jeremymatt/sugar_house_monitor/notes.txt

@reboot sleep 30 && DISPLAY=:0 /home/releaser/.venv/bin/python /home/releaser/sugar_house_monitor/ultrasonic_distance_test.py > /home/releaser/crontab.log 2>&1
https://sandboxelectronics.com/?product=sc16is750-i2cspi-to-uart-bridge-module
