jeremymatt/sugar_house_monitor/schematics/Figures.pptx

Flue O2
sensor

Holding tank
monitor

Transfer pump
controller

Flue temp
measurement

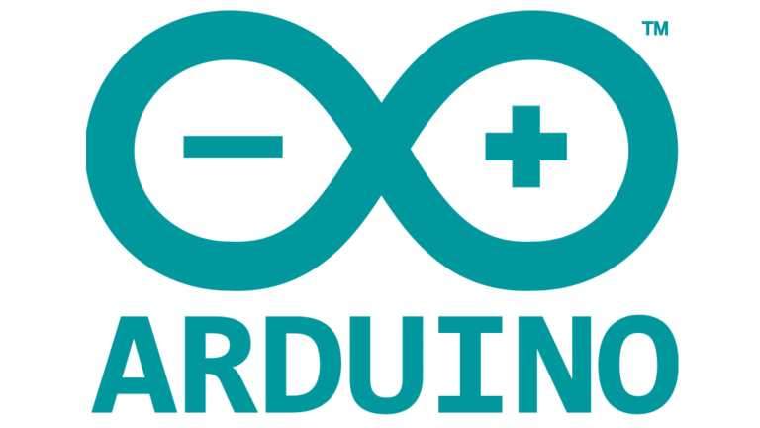
[picture p1: figure]
Arduino logo histoire et signification, evolution, symbole Arduino

Web browser
display

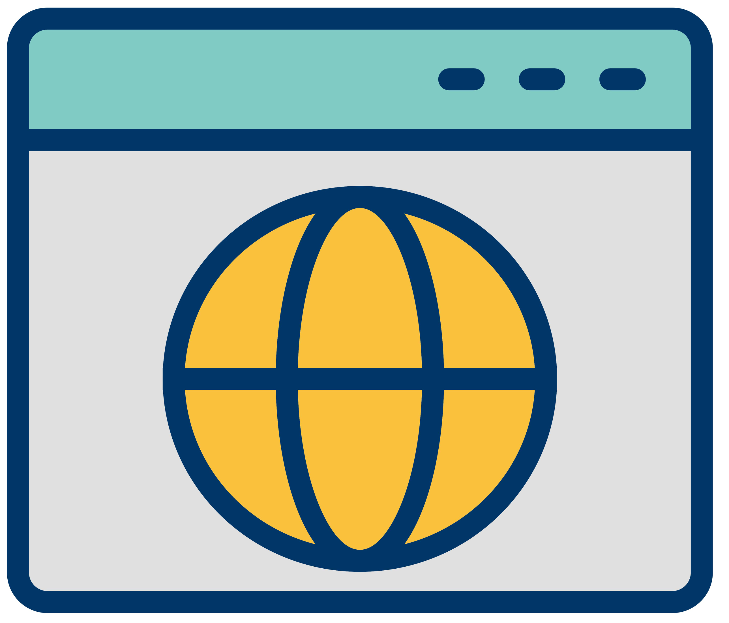
[picture p2: figure]
Vector Browser Icon 442546 Vector Art at Vecteezy

Webserver

Display
screen
