jeremymatt/sugar_house_monitor/schematics/pump_pi/screw_header_layout.pptx

Raspberry Pi header

GND

5V

GND

RED LED

GREEN LED

GND

5V

5V

Relay_in

unused

Relay_out

GND

GND

5V

GND

ADC ch0

ADC ch0

ADC ch1

(vacuum)

(tank full)

ADC ch2

ADC ch3

(manual pump)

(tank empty)

ADC ch4

ADC ch5

ADC ch6

(unused

(system on)

(system off)

ADC ch7

(reset errors
