jeremymatt/sugar_house_monitor/plot.png

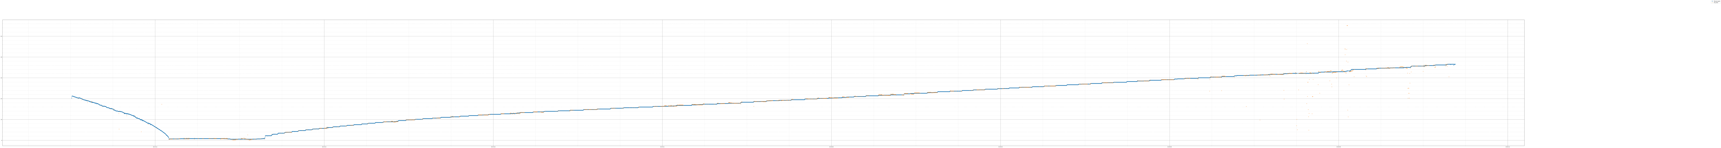
plot.png
