jeremymatt/sugar_house_monitor/schematics/Display case 3D files/complete_case.SLDASM

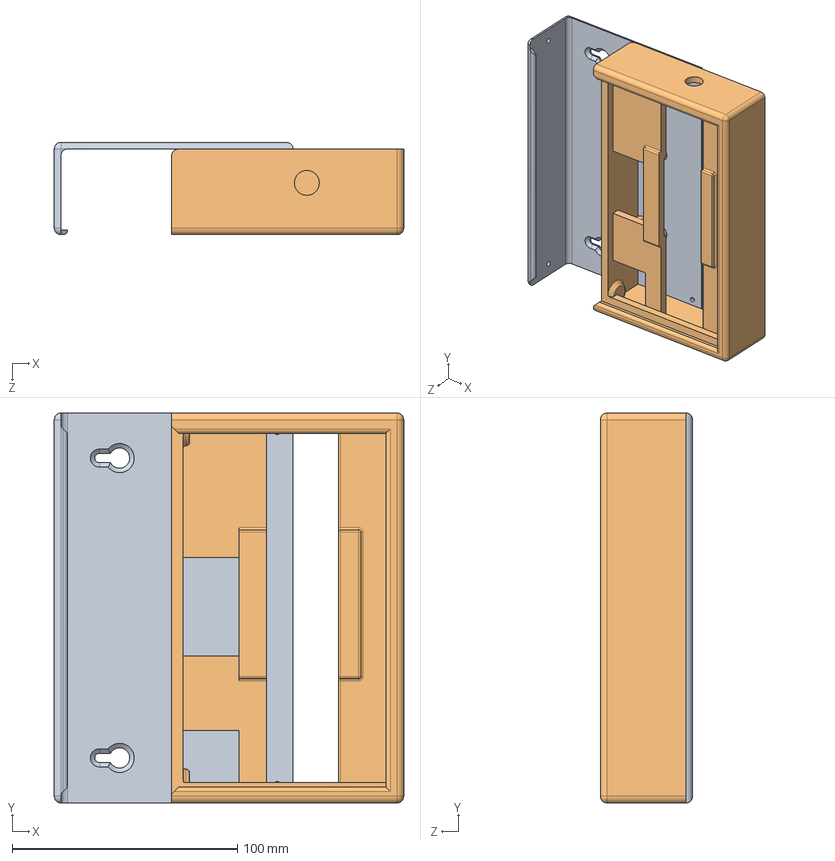
[picture p4: CAD file, 2026-06-21]
schematics/Display case 3D files/complete_case.SLDASM
155.1 x 173.0 x 41.0 mm
Main display case
Display case cover
