jeremymatt/sugar_house_monitor/schematics/Display case 3D files/Main display case.SLDPRT

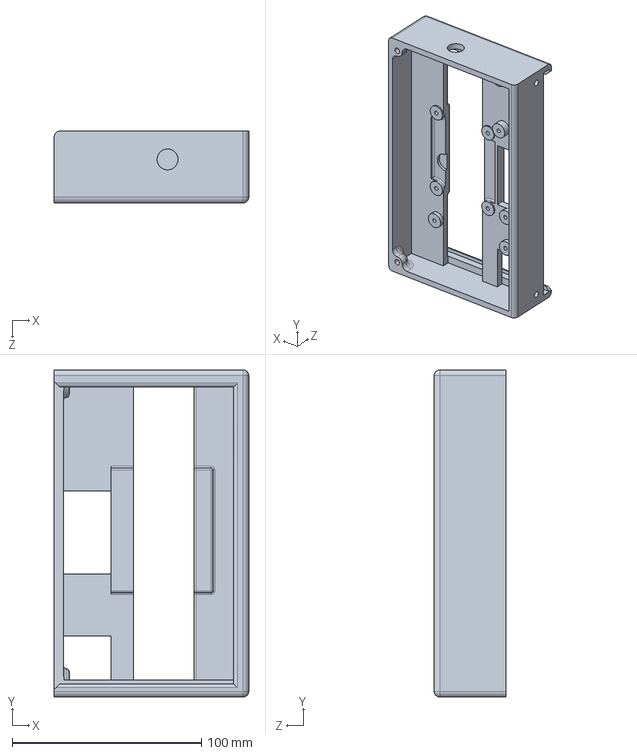
[picture p5: CAD file, 2026-06-21]
schematics/Display case 3D files/Main display case.SLDPRT
103.0 x 173.0 x 38.0 mm
