jeremymatt/sugar_house_monitor/schematics/Display case 3D files/Display case cover.SLDPRT

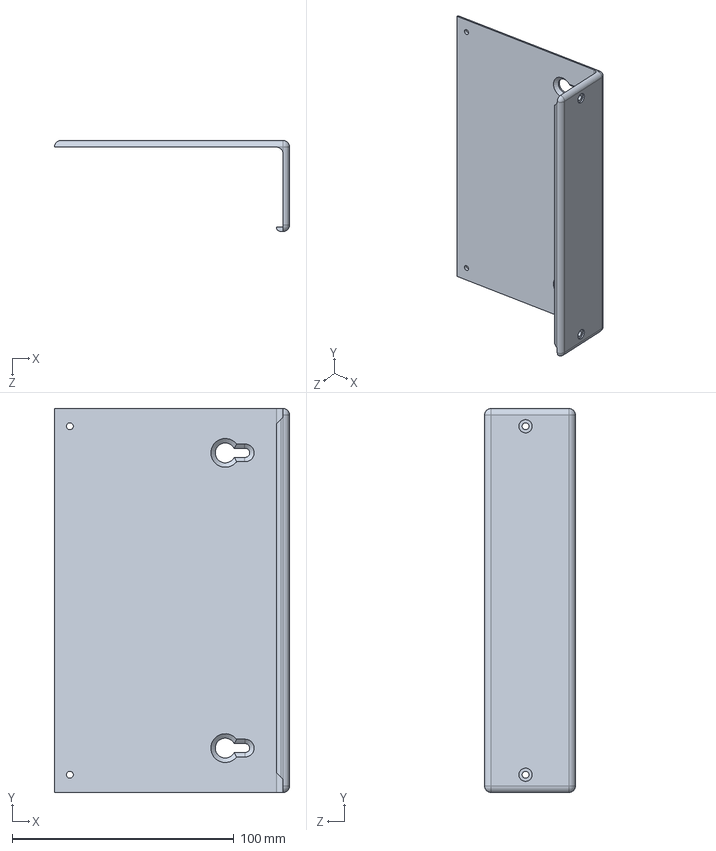
[picture p6: CAD file, 2026-06-21]
schematics/Display case 3D files/Display case cover.SLDPRT
106.0 x 173.0 x 41.0 mm
