jeremymatt/sugar_house_monitor/(list of files, cad)

Other CAD files:
schematics/Display case 3D files/Display case cover.STL
schematics/Display case 3D files/Main display case.3mf
schematics/Display case 3D files/Main display case.STL
