jeremymatt/sugar_house_monitor/bkup_2026-01-11/smoothing_testing/dataset/roadside_2025_04_04.csv

Unnamed: 0 | timestamp | yr | mo | day | hr | m | s | surf_dist | depth | gal
4708 | 2025-04-04 08:50:08.818582 | 2025.0 | 4.0 | 4.0 | 8.0 | 50.0 | 8.0 | 25.43 | 25.32 | 949.5
4709 | 2025-04-04 08:50:23.818658 | 2025.0 | 4.0 | 4.0 | 8.0 | 50.0 | 23.0 | 25.45 | 25.3 | 948.87
4710 | 2025-04-04 08:50:38.818622 | 2025.0 | 4.0 | 4.0 | 8.0 | 50.0 | 38.0 | 25.43 | 25.32 | 949.7
4711 | 2025-04-04 08:50:53.818643 | 2025.0 | 4.0 | 4.0 | 8.0 | 50.0 | 53.0 | 25.43 | 25.32 | 949.7
4712 | 2025-04-04 08:51:08.818652 | 2025.0 | 4.0 | 4.0 | 8.0 | 51.0 | 8.0 | 25.43 | 25.32 | 949.7
4713 | 2025-04-04 08:51:23.818701 | 2025.0 | 4.0 | 4.0 | 8.0 | 51.0 | 23.0 | 25.43 | 25.32 | 949.7
4714 | 2025-04-04 08:51:38.818661 | 2025.0 | 4.0 | 4.0 | 8.0 | 51.0 | 38.0 | 25.43 | 25.32 | 949.7
4715 | 2025-04-04 08:51:53.818726 | 2025.0 | 4.0 | 4.0 | 8.0 | 51.0 | 53.0 | 25.43 | 25.32 | 949.7
4716 | 2025-04-04 08:52:08.818703 | 2025.0 | 4.0 | 4.0 | 8.0 | 52.0 | 8.0 | 25.425 | 25.325000000000003 | 949.91
4717 | 2025-04-04 08:52:23.818760 | 2025.0 | 4.0 | 4.0 | 8.0 | 52.0 | 23.0 | 25.39 | 25.36 | 951.37
4718 | 2025-04-04 08:52:38.818719 | 2025.0 | 4.0 | 4.0 | 8.0 | 52.0 | 38.0 | 25.36 | 25.39 | 952.62
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
