jeremymatt/sugar_house_monitor/testdata/brookside.csv

Unnamed: 0 | timestamp | yr | mo | day | hr | m | s | surf_dist | depth | gal
318 | 2025-03-30 21:02:11.072244 | 2025.0 | 3.0 | 30.0 | 21.0 | 2.0 | 11.0 | 13.425 | 41.7 | 1350.32
319 | 2025-03-30 21:02:26.066835 | 2025.0 | 3.0 | 30.0 | 21.0 | 2.0 | 26.0 | 12.9475 | 42.18 | 1350.32
320 | 2025-03-30 21:02:41.066778 | 2025.0 | 3.0 | 30.0 | 21.0 | 2.0 | 41.0 | 13.53625 | 41.59 | 1350.32
321 | 2025-03-30 21:02:56.067176 | 2025.0 | 3.0 | 30.0 | 21.0 | 2.0 | 56.0 | 13.725 | 41.4 | 1350.32
322 | 2025-03-30 21:03:11.066261 | 2025.0 | 3.0 | 30.0 | 21.0 | 3.0 | 11.0 | 13.85 | 41.28 | 1350.32
323 | 2025-03-30 21:03:26.066451 | 2025.0 | 3.0 | 30.0 | 21.0 | 3.0 | 26.0 | 10.24625 | 44.88 | 1350.32
324 | 2025-03-30 21:03:41.066214 | 2025.0 | 3.0 | 30.0 | 21.0 | 3.0 | 41.0 | 98.06125 | -42.94 | 0.0
325 | 2025-03-30 21:03:56.066256 | 2025.0 | 3.0 | 30.0 | 21.0 | 3.0 | 56.0 | 120.1125 | -64.99 | 0.0
326 | 2025-03-30 21:04:11.066164 | 2025.0 | 3.0 | 30.0 | 21.0 | 4.0 | 11.0 | 98.2675 | -43.14 | 0.0
327 | 2025-03-30 21:04:26.067435 | 2025.0 | 3.0 | 30.0 | 21.0 | 4.0 | 26.0 | 70.33500000000001 | -15.21 | 0.0
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
