jeremymatt/sugar_house_monitor/testdata/roadside.csv

Unnamed: 0 | timestamp | yr | mo | day | hr | m | s | surf_dist | depth | gal
0 | 2025-03-30 21:02:10.366711 | 2025.0 | 3.0 | 30.0 | 21.0 | 2.0 | 10.0 | 18.17875 | 37.82 | 1471.35
1 | 2025-03-30 21:02:25.331935 | 2025.0 | 3.0 | 30.0 | 21.0 | 2.0 | 25.0 | 12.597499999999998 | 43.4 | 1520.53
2 | 2025-03-30 21:02:40.332445 | 2025.0 | 3.0 | 30.0 | 21.0 | 2.0 | 40.0 | 13.11625 | 42.88 | 1520.53
3 | 2025-03-30 21:02:55.331805 | 2025.0 | 3.0 | 30.0 | 21.0 | 2.0 | 55.0 | 13.31375 | 42.69 | 1520.53
4 | 2025-03-30 21:03:10.331566 | 2025.0 | 3.0 | 30.0 | 21.0 | 3.0 | 10.0 | 13.49125 | 42.51 | 1520.53
5 | 2025-03-30 21:03:25.331576 | 2025.0 | 3.0 | 30.0 | 21.0 | 3.0 | 25.0 | 11.4775 | 44.52 | 1520.53
6 | 2025-03-30 21:03:40.331475 | 2025.0 | 3.0 | 30.0 | 21.0 | 3.0 | 40.0 | 9.72125 | 46.28 | 1520.53
7 | 2025-03-30 21:03:55.331892 | 2025.0 | 3.0 | 30.0 | 21.0 | 3.0 | 55.0 | 9.77375 | 46.23 | 1520.53
8 | 2025-03-30 21:04:10.331520 | 2025.0 | 3.0 | 30.0 | 21.0 | 4.0 | 10.0 | 9.7925 | 46.21 | 1520.53
9 | 2025-03-30 21:04:25.331615 | 2025.0 | 3.0 | 30.0 | 21.0 | 4.0 | 25.0 | 9.81625 | 46.18 | 1520.53
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
