jeremymatt/sugar_house_monitor/bkup_2026-01-11/smoothing_testing/plots/brookside_hampel_flow_020.png

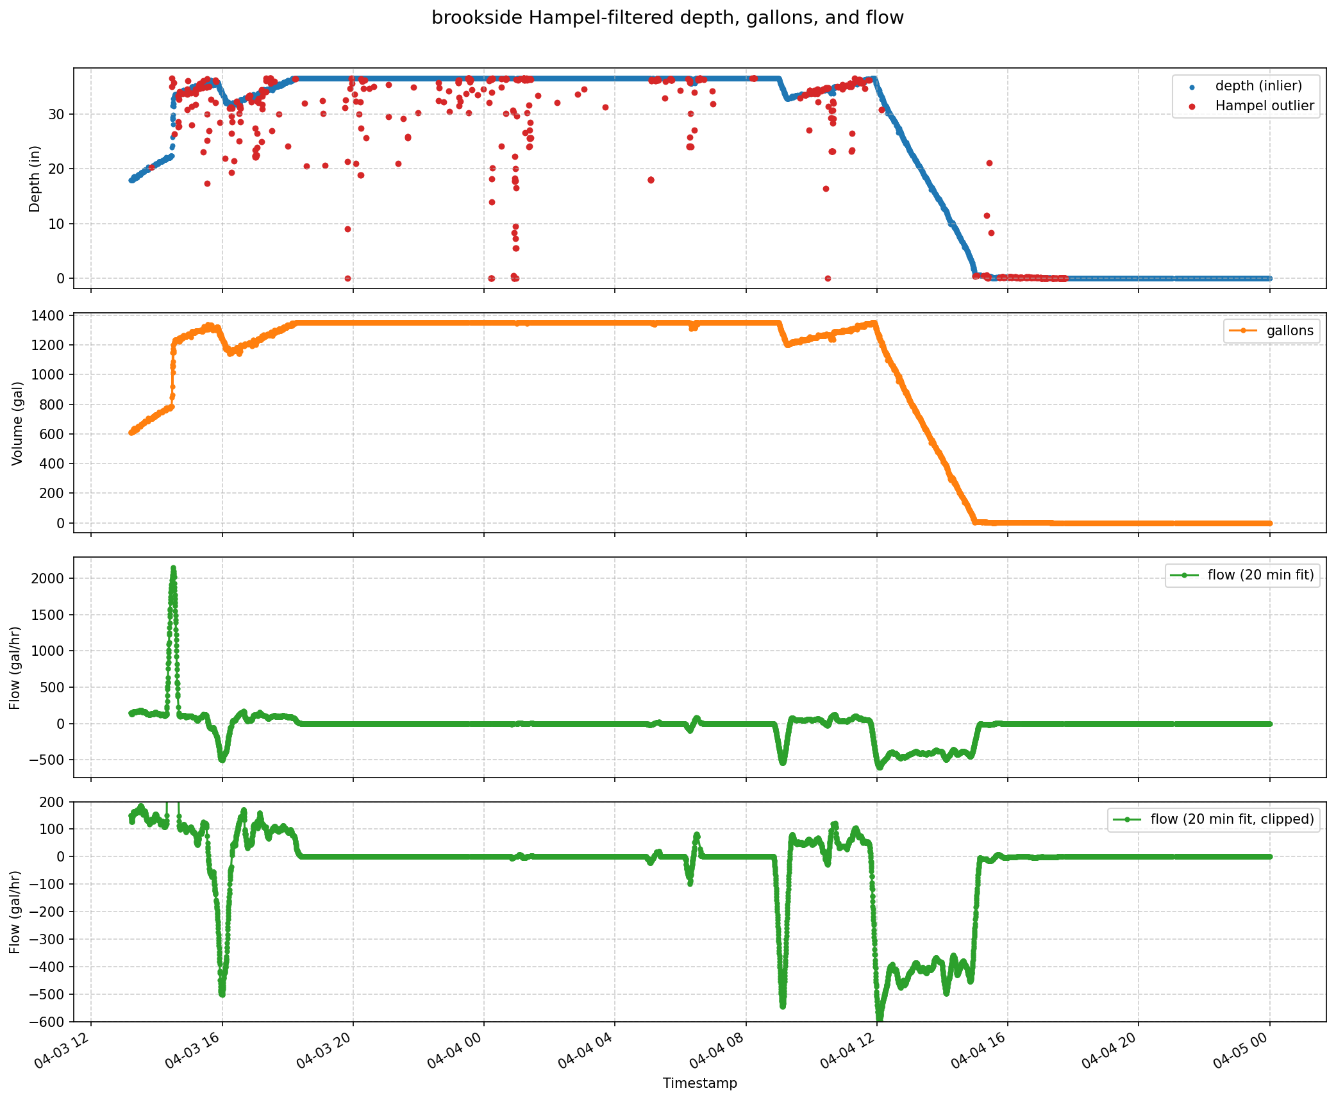
bkup_2026-01-11/smoothing_testing/plots/brookside_hampel_flow_020.png
