jeremymatt/sugar_house_monitor/bkup_2026-01-11/smoothing_testing/plots/evaporator_flow_summary.png

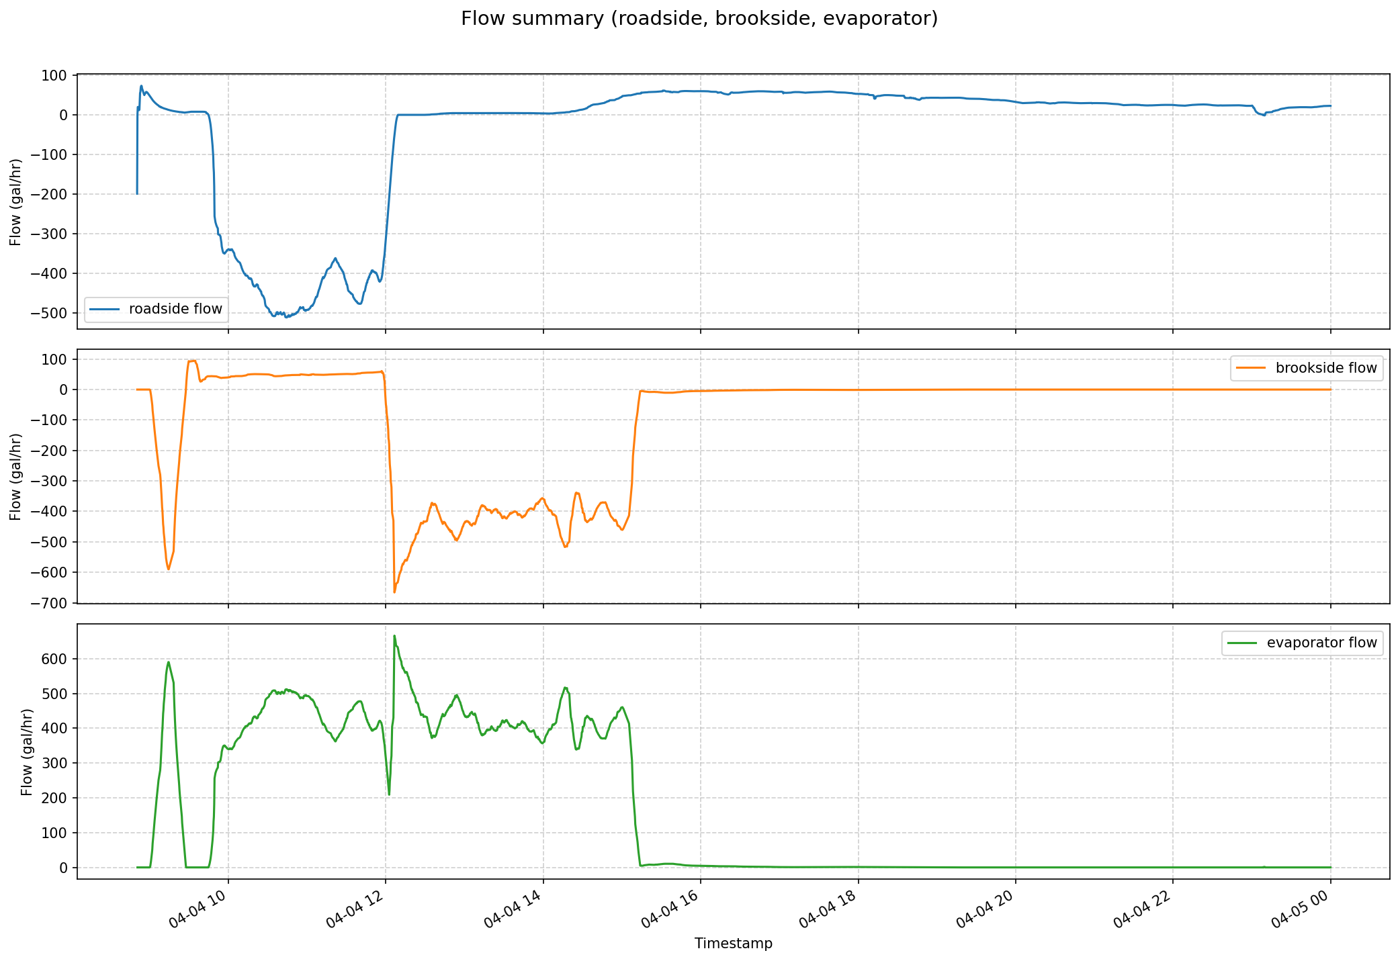
bkup_2026-01-11/smoothing_testing/plots/evaporator_flow_summary.png
