jeremymatt/sugar_house_monitor/bkup_2026-01-11/smoothing_testing/plots/roadside_hampel_flow_010.png

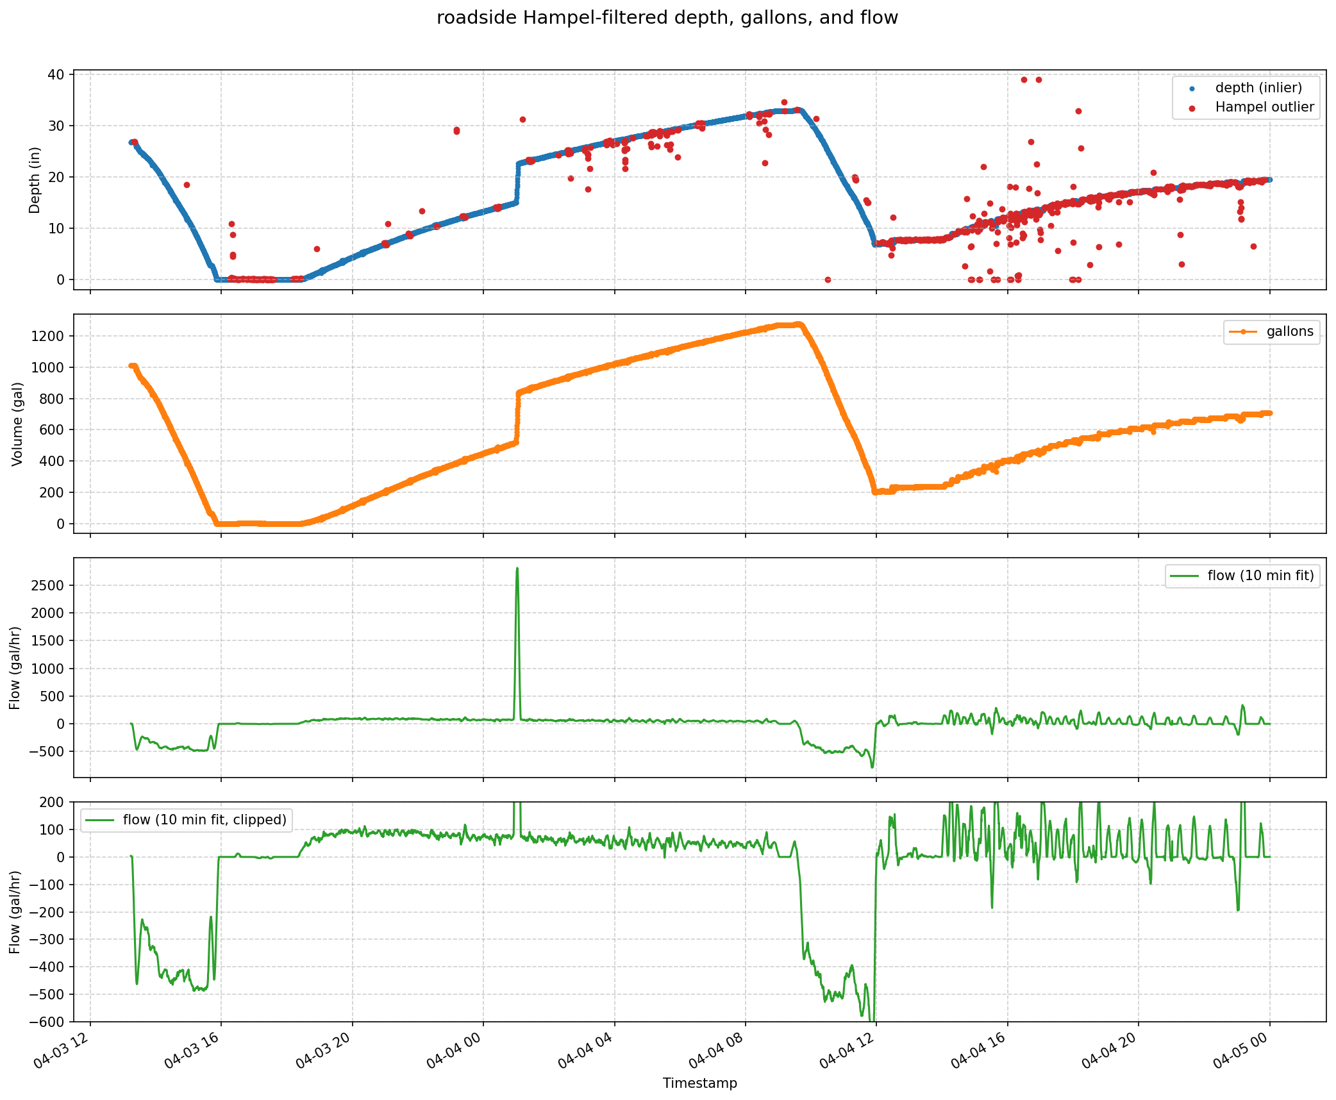
bkup_2026-01-11/smoothing_testing/plots/roadside_hampel_flow_010.png
