jeremymatt/sugar_house_monitor/schematics/pi_control_of_shut_off/pi_control_of_shut_off/pi_control_of_shut_off.kicad_pcb

## KiCad design Schematics/Precix Retrofit.kicad_sch

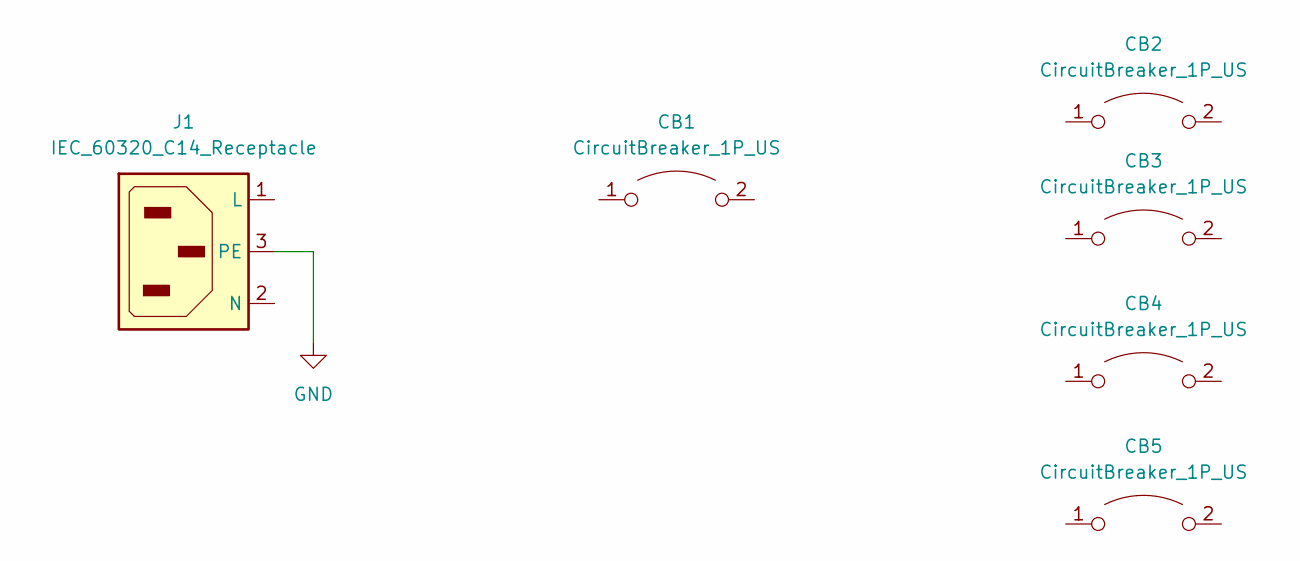
[picture p23: schematic Precix Retrofit.kicad_sch]

Parts:
CB1, CB2, CB3, CB4, CB5: CircuitBreaker_1P_US
J1: IEC_60320_C14_Receptacle

Connections:
GND: J1.3 (PE)
