jeremymatt/sugar_house_monitor/schematics/display_pi/display.kicad_sch

## KiCad design schematics/display_pi/display.kicad_sch (2026-06-21)

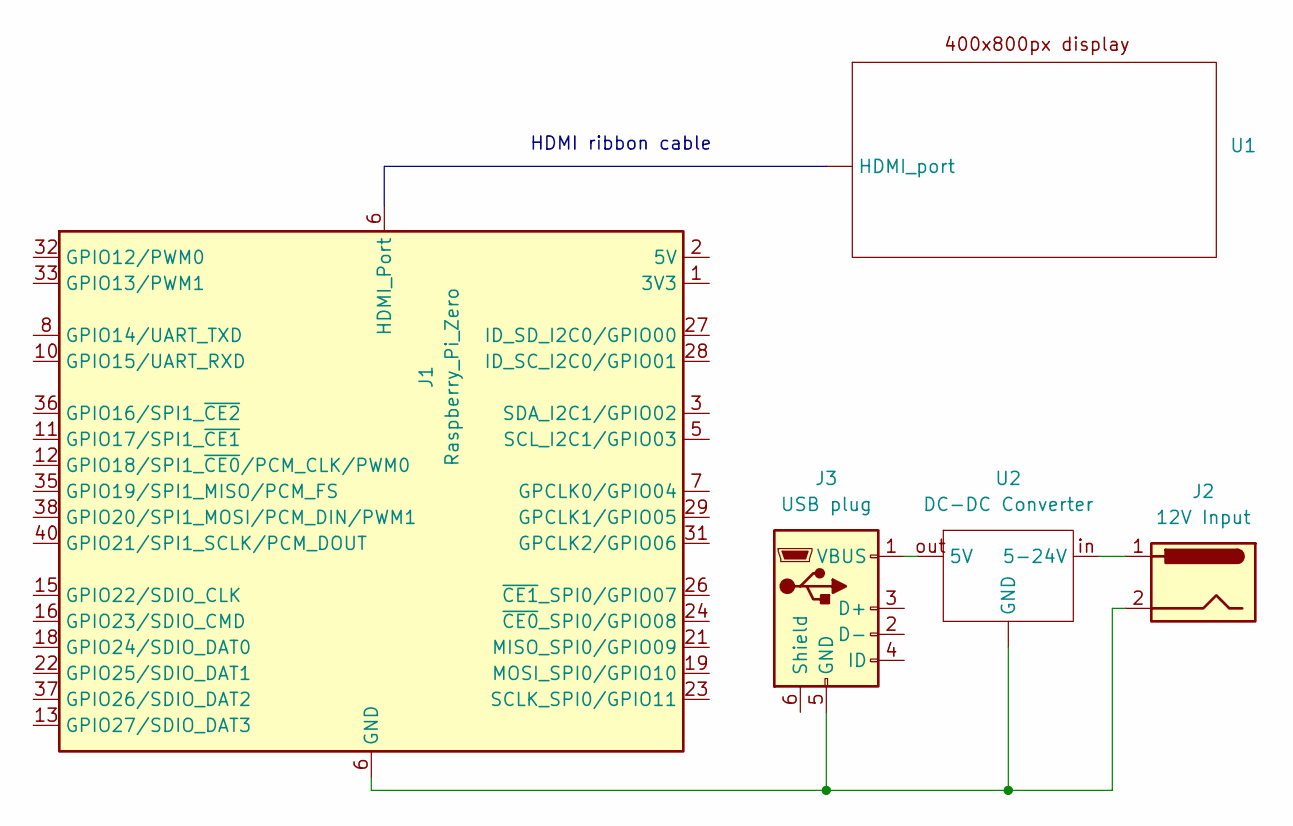
[picture p24: schematic display.kicad_sch]

Parts:
J1: Raspberry_Pi_Zero
J2: 12V Input
J3: USB plug
U1: (no value)
U2: DC-DC Converter

Connections:
unnamed: J1.1 (3V3), J1.17 (3V3)
unnamed: J1.2 (5V), J1.4 (5V)
unnamed: J1.6 (GND), J1.9 (GND), J1.14 (GND), J1.20 (GND), J1.25 (GND), J1.30 (GND), J1.34 (GND), J1.39 (GND), J2.2, J3.5 (GND), U2. (GND)
unnamed: J2.1, U2.in (5-24V)
unnamed: J3.1 (VBUS), U2.out (5V)

Notes on the sheet:
HDMI ribbon cable
