jeremymatt/sugar_house_monitor/schematics/o2_pi/o2_pi.kicad_sch

## KiCad design schematics/o2_pi/o2_pi.kicad_sch (2026-01-28)

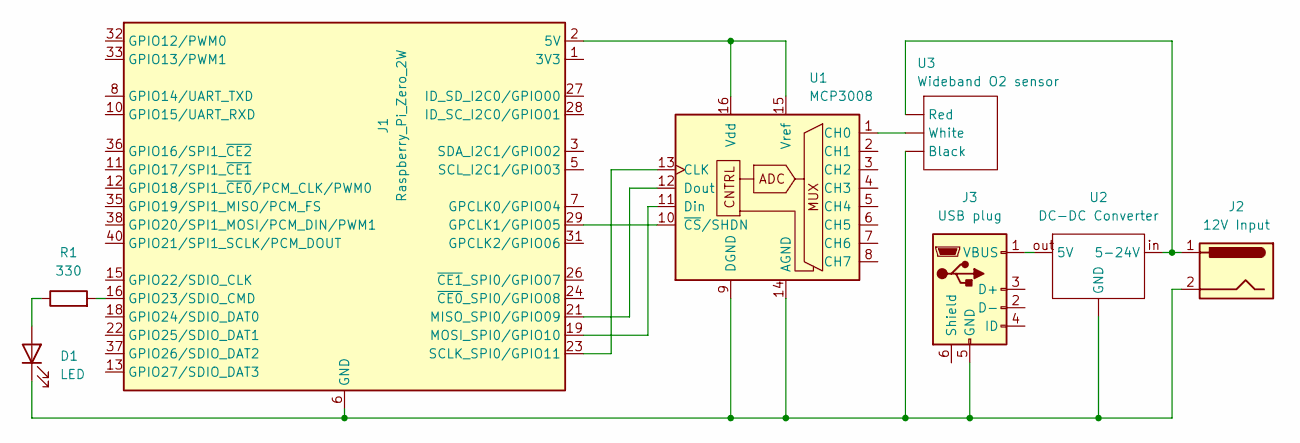
[picture p25: schematic o2_pi.kicad_sch]

Parts:
D1: LED
J1: Raspberry_Pi_Zero_2W
J2: 12V Input
J3: USB plug
R1: 330
U1: MCP3008
U2: DC-DC Converter
U3: Wideband O2 sensor

Connections:
unnamed: D1.1 (K), J1.6 (GND), J1.9 (GND), J1.14 (GND), J1.20 (GND), J1.25 (GND), J1.30 (GND), J1.34 (GND), J1.39 (GND), J2.2, J3.5 (GND), U1.9 (DGND), U1.14 (AGND), U2. (GND), U3.
unnamed: D1.2 (A), R1.1
unnamed: J1.1 (3V3), J1.17 (3V3)
unnamed: J1.2 (5V), J1.4 (5V), U1.15 (Vref), U1.16 (Vdd)
unnamed: J1.16 (GPIO23/SDIO_CMD), R1.2
unnamed: J1.19 (MOSI_SPI0/GPIO10), U1.11 (Din)
unnamed: J1.21 (MISO_SPI0/GPIO09), U1.12 (Dout)
unnamed: J1.23 (SCLK_SPI0/GPIO11), U1.13 (CLK)
unnamed: J1.29 (GPCLK1/GPIO05), U1.10 (~CS/SHDN)
unnamed: J2.1, U2.in (5-24V), U3.
unnamed: J3.1 (VBUS), U2.out (5V)
unnamed: U1.1 (CH0), U3.
