jeremymatt/sugar_house_monitor/schematics/pump_pi/pump_pi.kicad_sch

## KiCad design schematics/pump_pi/pump_pi.kicad_sch (2026-06-21)

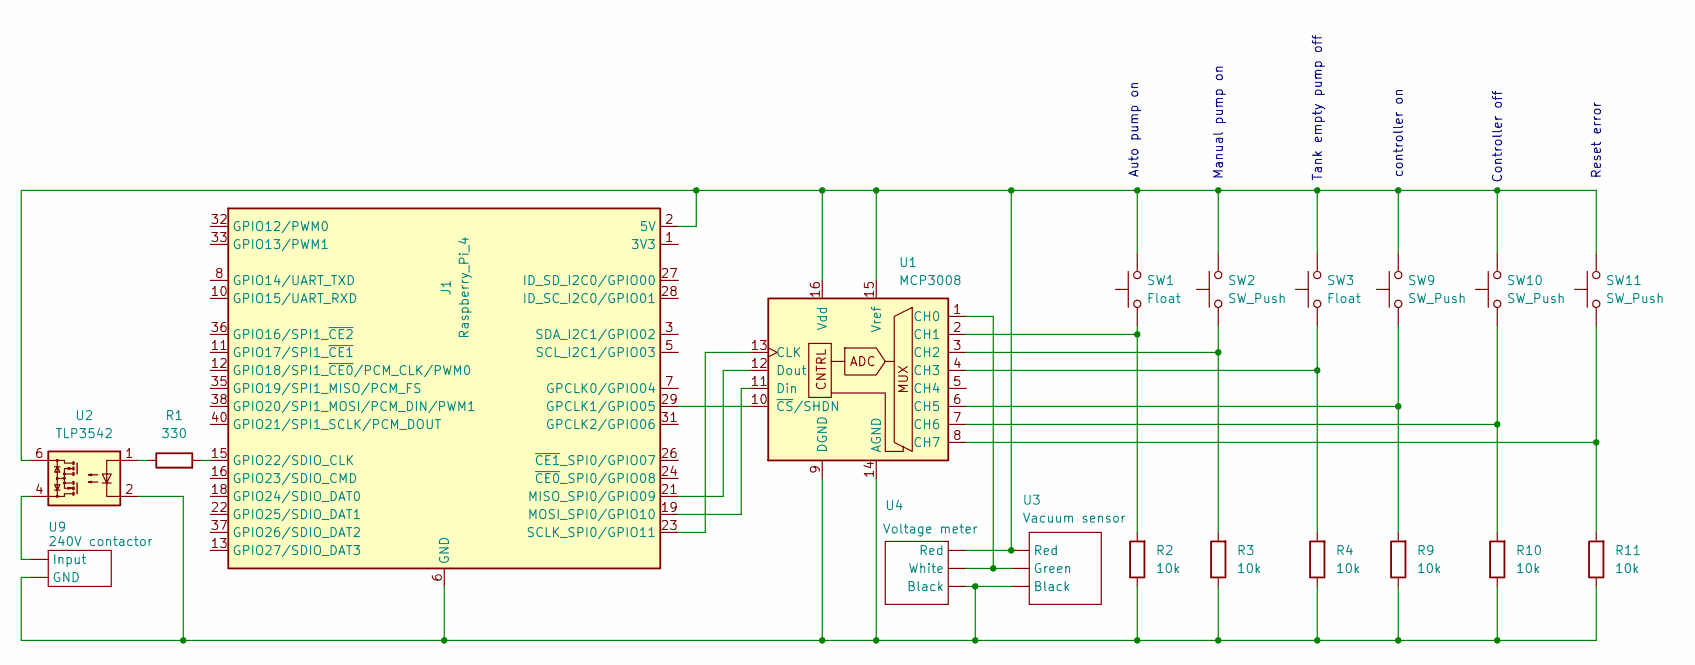
[picture p26: schematic pump_pi.kicad_sch]

Parts:
J1: Raspberry_Pi_4
R1: 330
R2, R3, R4, R9, R10, R11: 10k
SW1, SW3: Float
SW2, SW9, SW10, SW11: SW_Push
U1: MCP3008
U2: TLP3542; DIP-5-6_W7.62mm
U3: Vacuum sensor
U4: Voltage meter
U9: 240V contactor

Connections:
unnamed: J1.1 (3V3), J1.17 (3V3)
unnamed: J1.2 (5V), J1.4 (5V), SW1.2, SW2.2, SW3.2, SW9.2, SW10.2, SW11.2, U1.15 (Vref), U1.16 (Vdd), U2.6, U3., U4.
unnamed: J1.6 (GND), J1.9 (GND), J1.14 (GND), J1.20 (GND), J1.25 (GND), J1.30 (GND), J1.34 (GND), J1.39 (GND), R2.1, R3.1, R4.1, R9.1, R10.1, R11.1, U1.9 (DGND), U1.14 (AGND), U2.2, U3., U4., U9.
unnamed: J1.15 (GPIO22/SDIO_CLK), R1.2
unnamed: J1.19 (MOSI_SPI0/GPIO10), U1.11 (Din)
unnamed: J1.21 (MISO_SPI0/GPIO09), U1.12 (Dout)
unnamed: J1.23 (SCLK_SPI0/GPIO11), U1.13 (CLK)
unnamed: J1.29 (GPCLK1/GPIO05), U1.10 (~CS/SHDN)
unnamed: R1.1, U2.1
unnamed: R2.2, SW1.1, U1.2 (CH1)
unnamed: R3.2, SW2.1, U1.3 (CH2)
unnamed: R4.2, SW3.1, U1.4 (CH3)
unnamed: R9.2, SW9.1, U1.6 (CH5)
unnamed: R10.2, SW10.1, U1.7 (CH6)
unnamed: R11.2, SW11.1, U1.8 (CH7)
unnamed: U1.1 (CH0), U3., U4.
unnamed: U2.4, U9.

Notes on the sheet:
controller on
Reset error
Controller off
Tank empty pump off
Auto pump on
Manual pump on
