jeremymatt/sugar_house_monitor/schematics/tank_pi/tank_pi.kicad_sch

## KiCad design schematics/tank_pi/tank_pi.kicad_sch (2026-02-26)

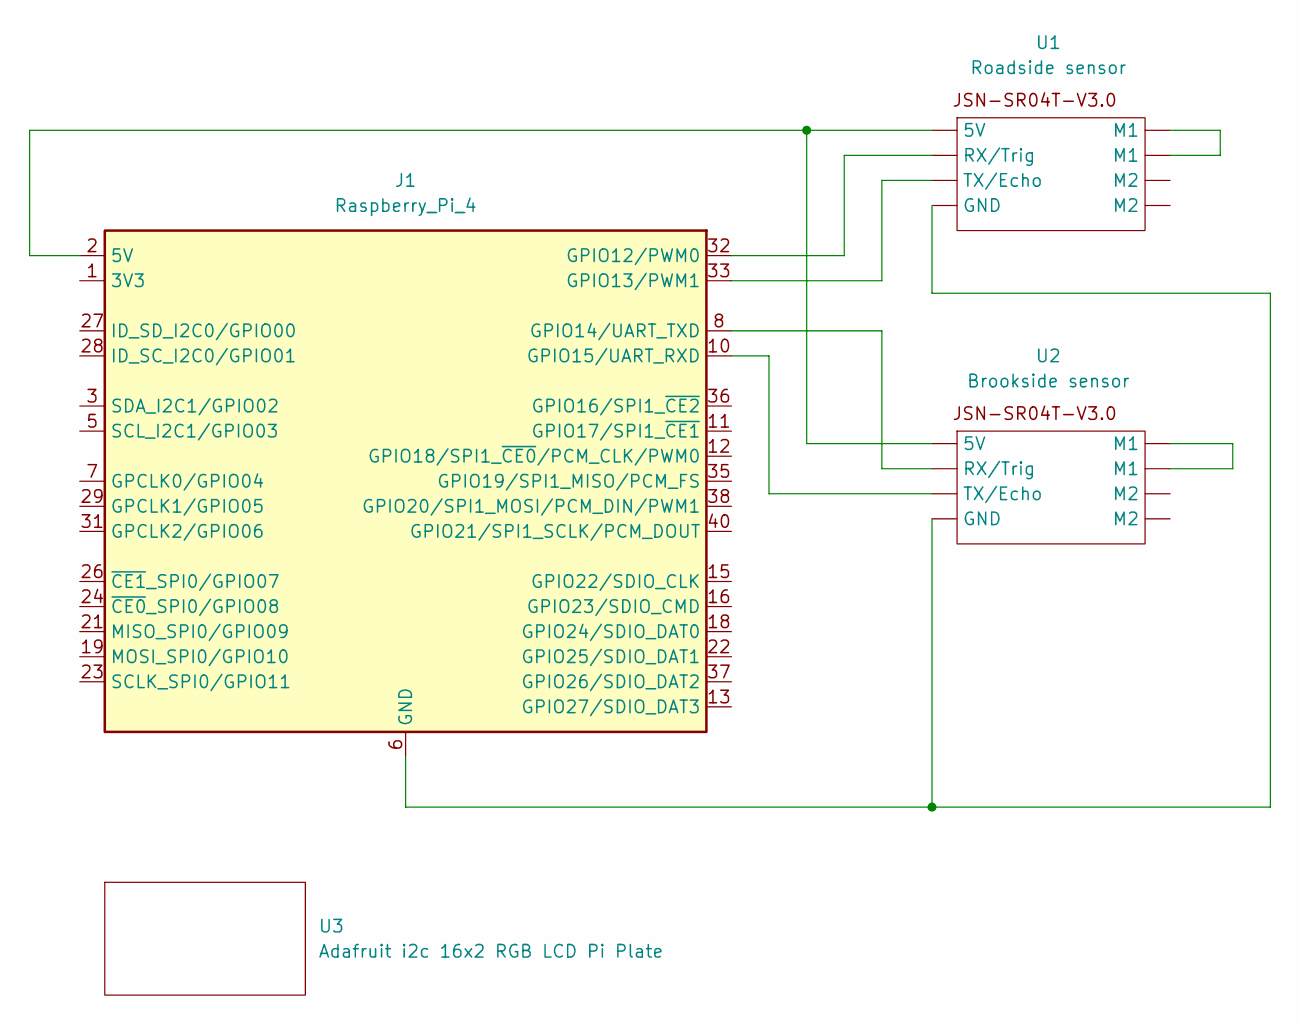
[picture p27: schematic tank_pi.kicad_sch]

Parts:
J1: Raspberry_Pi_4
U1: Roadside sensor
U2: Brookside sensor
U3: Adafruit i2c 16x2 RGB LCD Pi Plate

Connections:
unnamed: J1.1 (3V3), J1.17 (3V3)
unnamed: J1.2 (5V), J1.4 (5V), U1., U2.
unnamed: J1.8 (GPIO14/UART_TXD), U2.
unnamed: J1.10 (GPIO15/UART_RXD), U2.
unnamed: J1.6 (GND), J1.9 (GND), J1.14 (GND), J1.20 (GND), J1.25 (GND), J1.30 (GND), J1.34 (GND), J1.39 (GND), U1., U2.
unnamed: J1.32 (GPIO12/PWM0), U1.
unnamed: J1.33 (GPIO13/PWM1), U1.
