jeremymatt/sugar_house_monitor/schematics/temp_arduino/temp_arduino.kicad_sch

## KiCad design schematics/temp_arduino/temp_arduino.kicad_sch (2026-01-25)

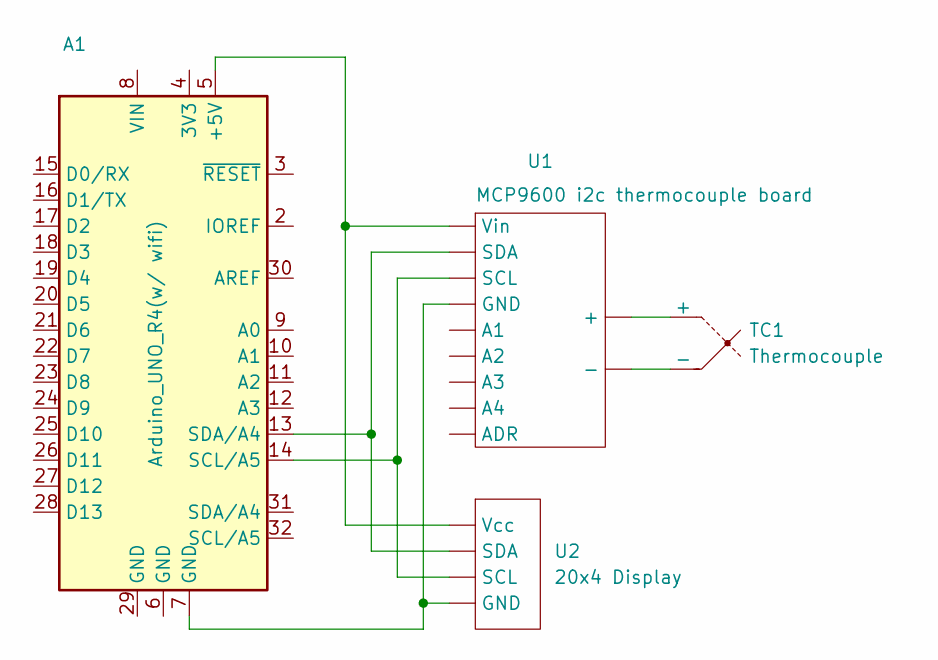
[picture p28: schematic temp_arduino.kicad_sch]

Parts:
A1: Arduino_UNO_R4(w/ wifi); Arduino_UNO_R3
TC1: Thermocouple
U1: MCP9600 i2c thermocouple board
U2: 20x4 Display

Connections:
unnamed: A1.5 (+5V), U1., U2.
unnamed: A1.7 (GND), U1., U2.
unnamed: A1.13 (SDA/A4), U1., U2.
unnamed: A1.14 (SCL/A5), U1., U2.
unnamed: TC1.1 (+), U1.
unnamed: TC1.2 (-), U1.
