jeremymatt/sugar_house_monitor/bkup_2025-11-16/working_edits/web_app.py

from flask import Flask, session, request, redirect, jsonify, render_template
import hashlib
import tank_vol_fcns as TVF
import time
import os
import datetime as dt
# from dotenv import load_dotenv

# Load environment variables from the credentials file
# load_dotenv(os.path.join(settings.path_to_repo, "flask_credentials.env"))

app = Flask(__name__)

# Get the secret key from the credentials file
# app.secret_key = os.getenv("FLASK_SECRET_KEY")

# if app.secret_key is None:
#     raise ValueError("No secret key found. Please ensure the credentials file is correctly set up.")


# Load credentials
# with open(os.path.join(settings.path_to_repo,'website_credentials.env'), 'r') as file:
#     credentials = file.read().splitlines()
#     USERNAME_HASH = credentials[0].strip()
#     PASSWORD_HASH = credentials[1].strip()


@app.route("/", methods=["GET", "POST"])
def index():
    if request.method == "POST":
        # username = request.form.get("username")
        # password = request.form.get("password")

        # if (hashlib.md5(username.encode()).hexdigest() == USERNAME_HASH and
        #         hashlib.md5(password.encode()).hexdigest() == PASSWORD_HASH):
        if True:
            session["authenticated"] = True
            return redirect("/")

    if session.get("authenticated"):
        return render_template("template.html")
    else:
        return render_template("template.html") 
        
@app.route('/update', methods=['GET','POST'])
def update():
    if request.method == "POST":
        action = request.json.get('command')
        print('received post request with action of: {}'.format(action))
        data = {}
        for name in TVF.tank_names:
            TVF.queue_dict[name]['command'].put(action)
            while TVF.queue_dict[name]['response'].empty():
                time.sleep(0.1)
            data[name] = TVF.queue_dict[name]['response'].get()
        data['system_time'] = dt.datetime.now().strftime('%Y-%m-%d %-I:%M%p')
        return jsonify(data)
    elif request.method == "GET":
        print('received get request')
        return  '''
                <!DOCTYPE html>
                <html>
                    <head>
                        <h1> HELLO WORLD </h1>
                    </head>
                    <body>
                        here be chickens
                    </body>
                </html>'''


@app.route("/logout", methods=["POST"])
def logout():
    session.clear()
    return redirect("/")
