jeremymatt/sugar_house_monitor/scripts/thermocouple_arduino.ino

#include <Wire.h>
// install the hd44780 library by Bill Perry
#include <Adafruit_I2CDevice.h>
#include <Adafruit_I2CRegister.h>
#include "Adafruit_MCP9600.h"
#include <hd44780.h>
#include <hd44780ioClass/hd44780_I2Cexp.h>
#include <WiFiS3.h>
#include <ArduinoHttpClient.h>
#include <time.h>

#define I2C_ADDRESS (0x67)

// Configure WiFi + API settings here or override via compiler flags.
#ifndef SHM_WIFI_SSID
#define SHM_WIFI_SSID "YOUR_WIFI_SSID"
#endif
#ifndef SHM_WIFI_PASSWORD
#define SHM_WIFI_PASSWORD "YOUR_WIFI_PASSWORD"
#endif
#ifndef SHM_API_KEY
#define SHM_API_KEY "REPLACE_WITH_API_KEY"
#endif
#ifndef SHM_API_HOST
#define SHM_API_HOST "mattsmaplesyrup.com"
#endif
#ifndef SHM_API_PATH
#define SHM_API_PATH "/sugar_house_monitor/api/ingest_stacktemp.php"
#endif
#ifndef SHM_SAMPLE_INTERVAL_MS
#define SHM_SAMPLE_INTERVAL_MS 1000UL  // default: 1 sample per second
#endif
#ifndef SHM_USE_TLS
#define SHM_USE_TLS 1  // set to 0 to force HTTP on port 80
#endif
#ifndef SHM_WIFI_RETRY_MS
#define SHM_WIFI_RETRY_MS 500UL
#endif
#ifndef SHM_WIFI_MAX_ATTEMPTS
#define SHM_WIFI_MAX_ATTEMPTS 10
#endif
#ifndef SHM_UPLOAD_RETRY_MS
#define SHM_UPLOAD_RETRY_MS 30000UL
#endif
#ifndef SHM_WINDOW_SIZE_MINUTES
#define SHM_WINDOW_SIZE_MINUTES 15
#endif
#ifndef SHM_I2C_CLOCK_HZ
#define SHM_I2C_CLOCK_HZ 50000UL
#endif

const char WIFI_SSID[] = SHM_WIFI_SSID;
const char WIFI_PASSWORD[] = SHM_WIFI_PASSWORD;
const char API_KEY[] = SHM_API_KEY;
const char API_HOST[] = SHM_API_HOST;
const char API_PATH[] = SHM_API_PATH;
const uint16_t API_PORT = SHM_USE_TLS ? 443 : 80;

const unsigned long SAMPLE_INTERVAL_MS = SHM_SAMPLE_INTERVAL_MS;
const unsigned long WIFI_RETRY_DELAY_MS = SHM_WIFI_RETRY_MS;
const int WIFI_ATTEMPTS = SHM_WIFI_MAX_ATTEMPTS;
const int SENSOR_FAILURE_THRESHOLD = 5;
const unsigned long SENSOR_RECOVERY_COOLDOWN_MS = 30000UL;
const int HTTP_FAILURE_THRESHOLD = 3;
const unsigned long WIFI_RECOVERY_COOLDOWN_MS = 30000UL;
const unsigned long WIFI_CONNECT_TIMEOUT_MS = WIFI_RETRY_DELAY_MS * WIFI_ATTEMPTS;
const unsigned long UPLOAD_RETRY_INTERVAL_MS = SHM_UPLOAD_RETRY_MS;
const unsigned long STALE_WARNING_TOGGLE_MS = 2000UL;
const unsigned long STALE_AFTER_MS = SAMPLE_INTERVAL_MS * 2;
const unsigned long I2C_CLOCK_HZ = SHM_I2C_CLOCK_HZ;
const int MCP_REINIT_RETRIES = 3;
const int window_size_minutes = SHM_WINDOW_SIZE_MINUTES;
const int WINDOW_BUFFER_MINUTES = SHM_WINDOW_SIZE_MINUTES * 4;
const unsigned long MINUTE_MS = 60000UL;

const uint8_t LCD_COLUMNS = 20;
const uint8_t LCD_ROWS = 4;
const uint8_t NET_STATUS_COL = LCD_COLUMNS - 4;
const uint8_t LCD_ARROW_UP = 0;
const uint8_t LCD_ARROW_DOWN = 1;

uint8_t lcdArrowUp[8] = {
  0x04,
  0x0E,
  0x15,
  0x04,
  0x04,
  0x04,
  0x04,
  0x00
};
uint8_t lcdArrowDown[8] = {
  0x00,
  0x04,
  0x04,
  0x04,
  0x04,
  0x15,
  0x0E,
  0x04
};

#if SHM_USE_TLS
WiFiSSLClient netClient;
#else
WiFiClient netClient;
#endif

Adafruit_MCP9600 mcp;
hd44780_I2Cexp lcd;
bool lcdReady = false;

/* Set and print ambient resolution */
Ambient_Resolution ambientRes = RES_ZERO_POINT_0625;

unsigned long lastSampleMs = 0;
int sensorFailureCount = 0;
unsigned long lastRecoveryMs = 0;
int httpFailureCount = 0;
unsigned long lastWifiRecoveryMs = 0;
bool wifiConnected = false;
bool wifiConnecting = false;
unsigned long wifiAttemptStartMs = 0;
unsigned long lastWifiAttemptMs = 0;
unsigned long nextUploadAttemptMs = 0;
bool lastUploadOk = false;
bool hasValidReading = false;
float lastHotF = 0.0f;
float lastColdF = 0.0f;
float lastWindowA = 0.0f;
float lastWindowB = 0.0f;
float lastWindowC = 0.0f;
float lastWindowD = 0.0f;
unsigned long lastGoodReadingMs = 0;
unsigned long lastDisplayToggleMs = 0;
bool showStaleWarningScreen = false;
bool lastStale = false;
bool lastNetOk = false;
bool lastDisplayWarning = false;
float stackMinuteSums[WINDOW_BUFFER_MINUTES];
uint16_t minuteSampleCounts[WINDOW_BUFFER_MINUTES];
int minuteWriteIndex = 0;
int minutesStored = 0;
float currentMinuteStackSum = 0.0f;
uint16_t currentMinuteCount = 0;
unsigned long currentMinuteStartMs = 0;

inline float C_to_F(float c) {
  return c * 9.0 / 5.0 + 32.0;
}

bool recoverI2cBus() {
#if defined(SCL) && defined(SDA)
  pinMode(SCL, INPUT_PULLUP);
  pinMode(SDA, INPUT_PULLUP);
  delayMicroseconds(5);

  bool sclLow = (digitalRead(SCL) == LOW);
  bool sdaLow = (digitalRead(SDA) == LOW);
  if (sclLow || sdaLow) {
    Serial.print("I2C recovery start: SCL=");
    Serial.print(sclLow ? "LOW" : "HIGH");
    Serial.print(" SDA=");
    Serial.println(sdaLow ? "LOW" : "HIGH");
  }

  if (sclLow || sdaLow) {
    for (int i = 0; i < 16; i++) {
      pinMode(SCL, OUTPUT);
      digitalWrite(SCL, LOW);
      delayMicroseconds(5);
      pinMode(SCL, INPUT_PULLUP);
      delayMicroseconds(5);
      if (digitalRead(SDA) == HIGH && digitalRead(SCL) == HIGH) {
        break;
      }
    }
  }

  // Generate a STOP to reset the bus.
  pinMode(SDA, OUTPUT);
  digitalWrite(SDA, LOW);
  delayMicroseconds(5);
  pinMode(SCL, INPUT_PULLUP);
  delayMicroseconds(5);
  pinMode(SDA, INPUT_PULLUP);
  delayMicroseconds(5);

  bool sclLowAfter = (digitalRead(SCL) == LOW);
  bool sdaLowAfter = (digitalRead(SDA) == LOW);
  if (sclLowAfter || sdaLowAfter) {
    Serial.print("I2C recovery incomplete: SCL=");
    Serial.print(sclLowAfter ? "LOW" : "HIGH");
    Serial.print(" SDA=");
    Serial.println(sdaLowAfter ? "LOW" : "HIGH");
  } else if (sclLow || sdaLow) {
    Serial.println("I2C recovery ok");
  }
  return !(sclLowAfter || sdaLowAfter);
#else
  return true;
#endif
}

int beginLcd() {
  const int status = lcd.begin(LCD_COLUMNS, LCD_ROWS);
  if (status == 0) {
    lcd.backlight();
    lcd.clear();
    lcd.createChar(LCD_ARROW_UP, lcdArrowUp);
    lcd.createChar(LCD_ARROW_DOWN, lcdArrowDown);
  }
  return status;
}

bool reinitLcd() {
  const int status = beginLcd();
  if (status != 0) {
    Serial.print("LCD reinit failed (status=");
    Serial.print(status);
    Serial.println(")");
    lcdReady = false;
    return false;
  }
  return true;
}

void initLcd() {
  const int status = beginLcd();
  if (status != 0) {
    Serial.print("LCD not found or init failed (status=");
    Serial.print(status);
    Serial.println(")");
    lcdReady = false;
    return;
  }
  lcdReady = true;
  Serial.println("LCD initialized");
}

void storeMinuteBucket() {
  stackMinuteSums[minuteWriteIndex] = currentMinuteStackSum;
  minuteSampleCounts[minuteWriteIndex] = currentMinuteCount;
  minuteWriteIndex = (minuteWriteIndex + 1) % WINDOW_BUFFER_MINUTES;
  if (minutesStored < WINDOW_BUFFER_MINUTES) {
    minutesStored += 1;
  }
  currentMinuteStackSum = 0.0f;
  currentMinuteCount = 0;
}

void advanceMinuteBuckets(unsigned long nowMs) {
  if (currentMinuteStartMs == 0) {
    currentMinuteStartMs = nowMs;
    return;
  }
  while (nowMs - currentMinuteStartMs >= MINUTE_MS) {
    storeMinuteBucket();
    currentMinuteStartMs += MINUTE_MS;
  }
}

void recordStackSample(float stackF) {
  currentMinuteStackSum += stackF;
  currentMinuteCount += 1;
}

void getMinuteBucket(int offsetMinutes, float &sum, uint16_t &count) {
  if (offsetMinutes == 0) {
    sum = currentMinuteStackSum;
    count = currentMinuteCount;
    return;
  }
  if (offsetMinutes > minutesStored) {
    sum = 0.0f;
    count = 0;
    return;
  }
  int index = minuteWriteIndex - offsetMinutes;
  if (index < 0) {
    index += WINDOW_BUFFER_MINUTES;
  }
  sum = stackMinuteSums[index];
  count = minuteSampleCounts[index];
}

float windowAverageStackF(int startOffsetMinutes) {
  float sum = 0.0f;
  uint32_t count = 0;
  for (int i = 0; i < window_size_minutes; i++) {
    float bucketSum = 0.0f;
    uint16_t bucketCount = 0;
    getMinuteBucket(startOffsetMinutes + i, bucketSum, bucketCount);
    sum += bucketSum;
    count += bucketCount;
  }
  if (count == 0) {
    return NAN;
  }
  return sum / static_cast<float>(count);
}

int tempForDisplay(float tempF) {
  if (isnan(tempF)) {
    return 0;
  }
  long rounded = (tempF >= 0.0f) ? static_cast<long>(tempF + 0.5f)
                                 : static_cast<long>(tempF - 0.5f);
  if (rounded > 9999) {
    rounded = 9999;
  } else if (rounded < -999) {
    rounded = -999;
  }
  return static_cast<int>(rounded);
}

void lcdPrintRow(uint8_t row, const char *text) {
  if (!lcdReady) {
    return;
  }
  lcd.setCursor(0, row);
  lcd.print(text);
  const int len = strlen(text);
  for (int i = len; i < LCD_COLUMNS; i++) {
    lcd.print(' ');
  }
}

void lcdPrintCenteredRow(uint8_t row, const char *text) {
  if (!lcdReady) {
    return;
  }
  char buffer[LCD_COLUMNS + 1];
  int len = strlen(text);
  if (len > LCD_COLUMNS) {
    len = LCD_COLUMNS;
  }
  for (int i = 0; i < LCD_COLUMNS; i++) {
    buffer[i] = ' ';
  }
  const int start = (LCD_COLUMNS - len) / 2;
  for (int i = 0; i < len; i++) {
    buffer[start + i] = text[i];
  }
  buffer[LCD_COLUMNS] = '\0';
  lcd.setCursor(0, row);
  lcd.print(buffer);
}

void lcdPrintNetStatus(bool netOk) {
  if (!lcdReady) {
    return;
  }
  lcd.setCursor(NET_STATUS_COL, 0);
  lcd.print("NET");
  lcd.write(netOk ? LCD_ARROW_UP : LCD_ARROW_DOWN);
}

void showStaleWarning(unsigned long elapsedMs) {
  if (!lcdReady) {
    return;
  }
  unsigned long totalSeconds = elapsedMs / 1000UL;
  unsigned long minutes = totalSeconds / 60UL;
  unsigned long seconds = totalSeconds % 60UL;
  if (minutes > 99) {
    minutes = 99;
  }
  char row4[LCD_COLUMNS + 1];
  snprintf(row4, sizeof(row4), "%02lu:%02lu (mm:ss) ago", minutes, seconds);
  lcdPrintCenteredRow(0, "WARNING");
  lcdPrintCenteredRow(1, "READING STALE");
  lcdPrintCenteredRow(2, "Last Update:");
  lcdPrintCenteredRow(3, row4);
}

void logStaleState(bool stale, unsigned long elapsedMs) {
  if (stale) {
    unsigned long totalSeconds = elapsedMs / 1000UL;
    unsigned long minutes = totalSeconds / 60UL;
    unsigned long seconds = totalSeconds % 60UL;
    Serial.print("STALE state detected; last update ");
    Serial.print(minutes);
    Serial.print("m");
    Serial.print(seconds);
    Serial.println("s ago");
  } else {
    Serial.println("STALE state cleared; readings fresh again");
  }
}

void updateLcd(float stackF, float ambientF,
               float windowA, float windowB, float windowC, float windowD,
               bool netOk) {
  if (!lcdReady) {
    return;
  }

  char row1[LCD_COLUMNS + 1];
  char row2[LCD_COLUMNS + 1];
  char row3[LCD_COLUMNS + 1];
  char row4[LCD_COLUMNS + 1];

  const int ambientDisplay = tempForDisplay(ambientF);
  const int stackDisplay = tempForDisplay(stackF);
  const int windowADisplay = tempForDisplay(windowA);
  const int windowBDisplay = tempForDisplay(windowB);
  const int windowCDisplay = tempForDisplay(windowC);
  const int windowDDisplay = tempForDisplay(windowD);

  snprintf(row1, sizeof(row1), "Ambient: %04dF", ambientDisplay);
  snprintf(row2, sizeof(row2), "Stack: %04dF", stackDisplay);
  snprintf(row3, sizeof(row3), "%03d:%04dF||%03d:%04dF",
           window_size_minutes, windowADisplay,
           window_size_minutes * 2, windowBDisplay);
  snprintf(row4, sizeof(row4), "%03d:%04dF||%03d:%04dF",
           window_size_minutes * 3, windowCDisplay,
           window_size_minutes * 4, windowDDisplay);

  lcdPrintRow(0, row1);
  lcdPrintRow(1, row2);
  lcdPrintRow(2, row3);
  lcdPrintRow(3, row4);
  lcdPrintNetStatus(netOk);
}

bool hasValidLocalIp(const IPAddress &ip) {
  // Treat 0.0.0.0 as "not really connected" so we wait for DHCP to finish.
  return ip != IPAddress(0, 0, 0, 0);
}

// Write ISO timestamp into buf (must be >= 25 bytes). Returns length, 0 on failure.
size_t isoTimestamp(char *buf, size_t bufSize) {
  time_t now = WiFi.getTime();
  if (now <= 0) {
    buf[0] = '\0';
    return 0;
  }
  tm *tm_info = gmtime(&now);
  if (!tm_info) {
    buf[0] = '\0';
    return 0;
  }
  return strftime(buf, bufSize, "%Y-%m-%dT%H:%M:%SZ", tm_info);
}

bool initMcp(bool verbose) {
  if (!mcp.begin(I2C_ADDRESS)) {
    if (verbose) {
      Serial.println("Sensor not found. Check wiring!");
    }
    return false;
  }

  if (verbose) {
    Serial.println("Found MCP9600!");
  }

  mcp.setAmbientResolution(ambientRes);
  if (verbose) {
    Serial.print("Ambient Resolution set to: ");
    switch (ambientRes) {
      case RES_ZERO_POINT_25:    Serial.println("0.25°C"); break;
      case RES_ZERO_POINT_125:   Serial.println("0.125°C"); break;
      case RES_ZERO_POINT_0625:  Serial.println("0.0625°C"); break;
      case RES_ZERO_POINT_03125: Serial.println("0.03125°C"); break;
    }
  }

  mcp.setADCresolution(MCP9600_ADCRESOLUTION_18);
  if (verbose) {
    Serial.print("ADC resolution set to ");
    switch (mcp.getADCresolution()) {
      case MCP9600_ADCRESOLUTION_18:   Serial.print("18"); break;
      case MCP9600_ADCRESOLUTION_16:   Serial.print("16"); break;
      case MCP9600_ADCRESOLUTION_14:   Serial.print("14"); break;
      case MCP9600_ADCRESOLUTION_12:   Serial.print("12"); break;
    }
    Serial.println(" bits");
  }

  mcp.setThermocoupleType(MCP9600_TYPE_K);
  if (verbose) {
    Serial.print("Thermocouple type set to ");
    switch (mcp.getThermocoupleType()) {
      case MCP9600_TYPE_K:  Serial.print("K"); break;
      case MCP9600_TYPE_J:  Serial.print("J"); break;
      case MCP9600_TYPE_T:  Serial.print("T"); break;
      case MCP9600_TYPE_N:  Serial.print("N"); break;
      case MCP9600_TYPE_S:  Serial.print("S"); break;
      case MCP9600_TYPE_E:  Serial.print("E"); break;
      case MCP9600_TYPE_B:  Serial.print("B"); break;
      case MCP9600_TYPE_R:  Serial.print("R"); break;
    }
    Serial.println(" type");
  }

  mcp.setFilterCoefficient(3);
  if (verbose) {
    Serial.print("Filter coefficient value set to: ");
    Serial.println(mcp.getFilterCoefficient());
  }

  mcp.setAlertTemperature(1, 30);
  if (verbose) {
    Serial.print("Alert #1 temperature set to ");
    Serial.println(mcp.getAlertTemperature(1));
  }
  mcp.configureAlert(1, true, true);  // alert 1 enabled, rising temp

  mcp.enable(true);
  return true;
}

bool recoverMcp() {
  unsigned long now = millis();
  if (now - lastRecoveryMs < SENSOR_RECOVERY_COOLDOWN_MS) {
    return false;
  }
  lastRecoveryMs = now;
  Serial.println("Reinitializing MCP9600...");
  Wire.end();
  delay(5);
  const bool busRecovered = recoverI2cBus();
  delay(5);
  Wire.begin();
  Wire.setClock(I2C_CLOCK_HZ);
#ifdef WIRE_HAS_TIMEOUT
  Wire.setWireTimeout(2500, true);
#endif
  if (busRecovered && lcdReady) {
    if (reinitLcd()) {
      Serial.println("LCD reinitialized after I2C recovery");
    }
  }
  for (int attempt = 1; attempt <= MCP_REINIT_RETRIES; attempt++) {
    if (initMcp(false)) {
      Serial.println("MCP9600 reinit ok");
      return true;
    }
    Serial.print("Reinit attempt ");
    Serial.print(attempt);
    Serial.println(" failed");
    delay(50);
  }
  Serial.println("MCP9600 reinit failed");
  return false;
}

void startWifiAttempt(unsigned long nowMs) {
  Serial.print("Connecting to WiFi SSID ");
  Serial.println(WIFI_SSID);
  WiFi.disconnect();
  WiFi.end();
  delay(100);
  if (strlen(WIFI_PASSWORD) == 0) {
    WiFi.begin(WIFI_SSID);
  } else {
    WiFi.begin(WIFI_SSID, WIFI_PASSWORD);
  }
  wifiConnecting = true;
  wifiAttemptStartMs = nowMs;
  lastWifiAttemptMs = nowMs;
}

void updateWifiState(unsigned long nowMs) {
  int status = WiFi.status();
  IPAddress ip = WiFi.localIP();
  if (status == WL_CONNECTED && hasValidLocalIp(ip)) {
    if (!wifiConnected) {
      Serial.print("WiFi connected, IP: ");
      Serial.println(ip);
      nextUploadAttemptMs = 0;
      lastUploadOk = false;
    }
    wifiConnected = true;
    wifiConnecting = false;
    return;
  }

  if (wifiConnected) {
    Serial.println("WiFi disconnected");
    lastUploadOk = false;
  } else if (status == WL_CONNECTED && !hasValidLocalIp(ip) && !wifiConnecting) {
    Serial.println("WiFi connected but missing IP lease; waiting...");
  }
  wifiConnected = false;

  if (wifiConnecting) {
    if (nowMs - wifiAttemptStartMs >= WIFI_CONNECT_TIMEOUT_MS) {
      Serial.println("WiFi connect attempt timed out");
      WiFi.disconnect();
      WiFi.end();
      wifiConnecting = false;
      lastWifiAttemptMs = nowMs;
    }
    return;
  }

  if (nowMs - lastWifiAttemptMs >= WIFI_RETRY_DELAY_MS) {
    startWifiAttempt(nowMs);
  }
}

void resetWifiClient() {
  netClient.stop();
  WiFi.disconnect();
  WiFi.end();
  wifiConnected = false;
  wifiConnecting = false;
  wifiAttemptStartMs = 0;
  lastWifiAttemptMs = 0;
  lastUploadOk = false;
}

bool sendTemps(float stackF, float ambientF) {
  if (!wifiConnected) {
    Serial.println("WiFi unavailable; skipping upload");
    return false;
  }
  if (WiFi.status() != WL_CONNECTED || !hasValidLocalIp(WiFi.localIP())) {
    wifiConnected = false;
    Serial.println("WiFi disconnected; skipping upload");
    return false;
  }

  // Build payload in a stack buffer — no heap String fragmentation
  char ts[25];
  isoTimestamp(ts, sizeof(ts));

  char payload[256];
  int payloadLen;
  if (ts[0]) {
    payloadLen = snprintf(payload, sizeof(payload),
      "{\"api_key\":\"%s\",\"readings\":[{\"stack_temp_f\":%.1f,"
      "\"ambient_temp_f\":%.1f,\"source_timestamp\":\"%s\"}]}",
      API_KEY, stackF, ambientF, ts);
  } else {
    payloadLen = snprintf(payload, sizeof(payload),
      "{\"api_key\":\"%s\",\"readings\":[{\"stack_temp_f\":%.1f,"
      "\"ambient_temp_f\":%.1f}]}",
      API_KEY, stackF, ambientF);
  }

  // Build path in a stack buffer
  char path[128];
  if (strchr(API_PATH, '?')) {
    snprintf(path, sizeof(path), "%s&api_key=%s", API_PATH, API_KEY);
  } else {
    snprintf(path, sizeof(path), "%s?api_key=%s", API_PATH, API_KEY);
  }

  Serial.print("POST ");
  Serial.print(API_HOST);
  Serial.print(':');
  Serial.print(API_PORT);
  Serial.println(path);

  HttpClient httpClient(netClient, API_HOST, API_PORT);
  httpClient.beginRequest();
  httpClient.post(path);
  httpClient.sendHeader("Content-Type", "application/json");
  httpClient.sendHeader("X-API-Key", API_KEY);
  httpClient.sendHeader("Content-Length", payloadLen);
  httpClient.beginBody();
  httpClient.print(payload);
  httpClient.endRequest();

  int status = httpClient.responseStatusCode();
  httpClient.responseBody();  // drain response
  httpClient.stop();

  if (status < 200 || status >= 300) {
    if (status < 0) {
      Serial.println("No HTTP response (connection/TLS issue?)");
    }
    Serial.print("Upload failed (HTTP ");
    Serial.print(status);
    Serial.println(")");

    // Attempt WiFi recovery after repeated HTTP/TLS failures.
    httpFailureCount += 1;
    if (status < 0) {
      unsigned long now = millis();
      if (httpFailureCount >= HTTP_FAILURE_THRESHOLD && (now - lastWifiRecoveryMs) >= WIFI_RECOVERY_COOLDOWN_MS) {
        Serial.println("Resetting WiFi after repeated HTTP failures...");
        resetWifiClient();
        lastWifiRecoveryMs = now;
        httpFailureCount = 0;
      }
    }
    return false;
  }

  httpFailureCount = 0;
  Serial.print("Upload ok (HTTP ");
  Serial.print(status);
  Serial.println(")");
  return true;
}

void setup()
{
  Serial.begin(115200);
  // Wait for Serial but time out after 3s so board works without USB
  {
    unsigned long serialWait = millis();
    while (!Serial && millis() - serialWait < 3000) {
      delay(10);
    }
  }
  Serial.println("MCP9600 HW test");

  if (WiFi.status() == WL_NO_MODULE) {
    Serial.println("ERROR: WiFi module not found!");
    while (true);
  }
  Serial.print("WiFi firmware version: ");
  Serial.println(WiFi.firmwareVersion());

  netClient.setTimeout(15000);
  Wire.begin();
  Wire.setClock(I2C_CLOCK_HZ);
#ifdef WIRE_HAS_TIMEOUT
  Wire.setWireTimeout(2500, true);
#endif

  /* Initialise the driver with I2C_ADDRESS and the default I2C bus. */
  if (!initMcp(true)) {
    while (1);
  }

  initLcd();

  startWifiAttempt(millis());

  Serial.println(F("------------------------------"));
}


void loop()
{
  const unsigned long now = millis();
  updateWifiState(now);
  bool newReadingOk = false;

  if (now - lastSampleMs >= SAMPLE_INTERVAL_MS) {
    lastSampleMs = now;
    advanceMinuteBuckets(now);

    float hotC  = mcp.readThermocouple();
    delay(5);
    float coldC = mcp.readAmbient();

    if (isnan(hotC) || isnan(coldC)) {
      sensorFailureCount += 1;
      Serial.println("Sensor read failed; skipping sample");
      if (sensorFailureCount >= SENSOR_FAILURE_THRESHOLD) {
        if (recoverMcp()) {
          sensorFailureCount = 0;
        }
      }
    } else {
      sensorFailureCount = 0;

      const float hotF = C_to_F(hotC);
      const float coldF = C_to_F(coldC);

      recordStackSample(hotF);

      const float windowA = windowAverageStackF(0);
      const float windowB = windowAverageStackF(window_size_minutes);
      const float windowC = windowAverageStackF(window_size_minutes * 2);
      const float windowD = windowAverageStackF(window_size_minutes * 3);

      Serial.print("Stack (hot junction): ");
      Serial.print(hotF, 2);
      Serial.println(" F");

      Serial.print("Ambient (cold junction): ");
      Serial.print(coldF, 2);
      Serial.println(" F");

      if (wifiConnected && now >= nextUploadAttemptMs) {
        const bool uploadOk = sendTemps(hotF, coldF);
        lastUploadOk = uploadOk;
        if (uploadOk) {
          nextUploadAttemptMs = now;
        } else {
          nextUploadAttemptMs = now + UPLOAD_RETRY_INTERVAL_MS;
        }
      }

      lastHotF = hotF;
      lastColdF = coldF;
      lastWindowA = windowA;
      lastWindowB = windowB;
      lastWindowC = windowC;
      lastWindowD = windowD;
      hasValidReading = true;
      lastGoodReadingMs = now;
      newReadingOk = true;
    }
  }

  const bool stale = hasValidReading && (now - lastGoodReadingMs >= STALE_AFTER_MS);
  bool displayToggle = false;
  if (stale) {
    if (!lastStale) {
      showStaleWarningScreen = true;
      lastDisplayToggleMs = now;
      displayToggle = true;
    } else if (now - lastDisplayToggleMs >= STALE_WARNING_TOGGLE_MS) {
      showStaleWarningScreen = !showStaleWarningScreen;
      lastDisplayToggleMs = now;
      displayToggle = true;
    }
  } else {
    if (lastStale) {
      displayToggle = true;
    }
    showStaleWarningScreen = false;
  }
  if (stale != lastStale) {
    logStaleState(stale, now - lastGoodReadingMs);
  }
  lastStale = stale;

  // Brief gap between sensor I2C reads and LCD I2C writes
  if (newReadingOk) {
    delay(5);
  }

  const bool netOk = wifiConnected && lastUploadOk;
  const bool displayUpdateNeeded = newReadingOk || displayToggle || (netOk != lastNetOk);
  if (displayUpdateNeeded) {
    const bool displayWarning = stale && showStaleWarningScreen;
    if (displayWarning) {
      showStaleWarning(now - lastGoodReadingMs);
    } else {
      updateLcd(lastHotF, lastColdF, lastWindowA, lastWindowB, lastWindowC, lastWindowD, netOk);
    }
    if (displayWarning != lastDisplayWarning) {
      Serial.print("Display mode: ");
      Serial.println(displayWarning ? "WARNING" : "NORMAL");
      lastDisplayWarning = displayWarning;
    }
    lastNetOk = netOk;
  }

  // Prevent tight-looping; 50ms is plenty responsive for 1Hz sampling
  delay(50);
}
