jeremymatt/sugar_house_monitor/(commit log)

2025-01-11 test of ultrasonic measurement
2025-03-29 working hardware for both sensors
    [brookside copy.csv, brookside.csv, brookside_working.csv, brookside_working2.csv, brookside_working3.csv]
2025-04-05 update website update fcn
    [brookside.csv, nan.csv, roadside.csv]
2025-11-17 pump_times.csv sample
    [pump_times.csv]
2025-11-17 organize sample data
    [brookside copy.csv, brookside.csv, brookside_working.csv, brookside_working2.csv, brookside_working3.csv, pump_times.csv, roadside.csv]
2025-11-17 upload sample data
    [brookside.csv, pump_times.csv, roadside.csv]
2025-11-19 update main.py for pump pi
2025-11-19 update backup tank vol functions to print the tank vols to the console
2025-11-20 bugfix update from gpt
    [main.py, process_status.py, synthetic_clock.py, tank_vol_fcns.py]
2025-11-24 add boiling status
    [brookside.csv, pump_times.csv, roadside.csv]
2025-11-25 handle nan in pump stream
2025-11-28 update vacuum test script
    [vacuum_cal.csv]
2025-11-29 previously commit worked; adding pump_pi logic
2025-11-29 update pump pi error handling
    [main_pump.py, process_status.py]
2025-11-29 update error handling for pump pi
    [main_pump.py]
2025-11-30 update debugging logging on pump pi
2025-12-05 stability fixes to tank py script
    [main.py]
2025-12-06 update pump pi controller to create local DB if missing
    [main_pump.py, process_status.py]
2025-12-06 update tankpi error handling
    [main.py, tank_vol_fcns.py]
2025-12-07 add data retention policy and update evaporator flow calculation
2025-12-07 update debug data
    [brookside.csv, pump_times.csv, roadside.csv]
2025-12-08 update real data and display script
    [brookside.csv, pump_times.csv, roadside.csv]
2025-12-08 add debugging printouts to display py
2025-12-08 updated real data
    [brookside.csv, pump_times.csv, roadside.csv]
2025-12-14 starting smoothing testing
    [brookside_2025_04_03.csv, brookside_2025_04_04.csv, brookside_2025_04_06.csv, brookside_2025_04_07.csv, brookside_2025_04_08.csv, roadside_2025_04_03.csv, roadside_2025_04_04.csv, roadside_2025_04_05.csv]
2025-12-15 some filtering working
    [brookside_2025_04_06.csv, brookside_2025_04_07.csv, brookside_2025_04_08.csv, roadside_2025_04_04.csv, roadside_2025_04_05.csv, roadside_2025_04_06.csv, roadside_2025_04_07.csv, roadside_2025_04_08.csv]
2025-12-15 smoothing continues, hampel is winning
    [brookside.csv, roadside.csv]
2025-12-16 add temperature readings
2025-12-20 update tank_vol_fcns to use median of instantaneous depth readings
    [brookside.csv, pump_times.csv, roadside.csv]
2025-12-20 update evap flow code
2025-12-21 update flow smoothing testing
    [brookside.csv, roadside.csv]
2025-12-21 update smoothing testing
    [brookside.csv, roadside.csv]
2025-12-27 various smoothing testing experiments
    [brookside.csv, brookside_2025_04_03.csv, brookside_2025_04_04.csv, brookside_2025_04_06.csv, brookside_2025_04_07.csv, brookside_2025_04_08.csv, roadside.csv, roadside_2025_04_03.csv]
2025-12-28 test savgol filtering
2025-12-29 smoothing testing complete
    [brookside.csv, brookside_2025_04_04.csv, roadside.csv, roadside_2025_04_04.csv]
2025-12-30 transfer smoothing testing algorithm to main codebase
    [brookside.csv, brookside_2025_04_03.csv, brookside_2025_04_04.csv, evaporator_flow.csv, evaporator_flow_copy.csv, evaporator_from_webserver.csv, roadside.csv, roadside_2025_04_03.csv]
2025-12-31 match production to test code
    [evaporator_flow_copy.csv, evaporator_from_webserver.csv]
2025-12-31 update bugfix
    [evaporator_from_webserver.csv]
2026-01-01 bugfix for flow calcs
    [main.py, process_status.py, tank_vol_fcns.py]
2026-01-02 bugfixes and processing delays investigation
    [tank_vol_fcns.py]
2026-01-05 update web interface
    [brookside.csv, pump_times.csv, roadside.csv]
2026-01-11 update pump controller for robust multiprocessing
2026-01-11 add logrotate for the pump pi
2026-01-11 pump controller lag bugfix
    [main_pump.py, upload_service.py]
2026-01-11 update setup_environment.sh to install wheel
2026-01-13 update thermocouple arduino code to handle missing network
    [thermocouple_arduino.ino]
2026-01-14 update arduino code
2026-01-16 tank controller dup process bugfix
    [main_tank.py]
2026-01-18 start schematics for documetatnion
    [display_pi.kicad_pcb, display_pi.kicad_sch, pump_pi.kicad_pcb, pump_pi.kicad_sch, tank_pi.kicad_pcb, tank_pi.kicad_sch, temp_arduino.kicad_pcb, temp_arduino.kicad_sch]
2026-01-19 update schematics
    [pump_pi.kicad_sch, tank_pi.kicad_sch, temp_arduino.kicad_sch]
2026-01-19 update pump controller to handle additional logic inputs from the ADC
2026-01-20 pump controller bugfixes
2026-01-25 o2 test code
    [oh_two_cal.csv]
2026-01-28 prior commit working; add in o2 sensor pi
2026-01-28 update o2 sensor console logging
2026-01-28 update schematics and web summary card layout
    [o2_pi.kicad_pcb, o2_pi.kicad_sch]
2026-01-28 update to lambda radio
    [oh_two_cal.csv]
2026-01-31 claude update pump_pi controller to have LED status indicator
2026-02-28 expose logic inversion on ADC channels
2026-02-28 update arduino code to hopefully connect to open wifi
2026-03-05 tank volume calculation bugfix
    [tank_vol_fcns.py]
2026-03-05 update pump interval display
2026-03-08 hopefully improve thermocouple arduino stability
    [thermocouple_arduino.ino]
2026-03-08 bugfix for display pi logging implementation
    [main_display.py]
2026-06-21 Update schematics and figures
    [.kicad_sch, .kicad_sch.kicad_sch, Display case cover.SLDPRT, Display case cover.STL, Main display case.3mf, Main display case.SLDPRT, Main display case.STL, complete_case.SLDASM]
